Magicraps/Volt/README.md

# Volt
Vehicle Operations and Launch Telemetry - AerospaceNU's rocketry flight controller
https://github.com/AerospaceNU

Currently working on V1.
Open files in KiCAD. (I'm currently using V9.0)
