Magicraps/Volt/VoltV1/VoltV1.kicad_pcb

## KiCad design VoltV1/VoltV1.kicad_pcb (2026-06-28)

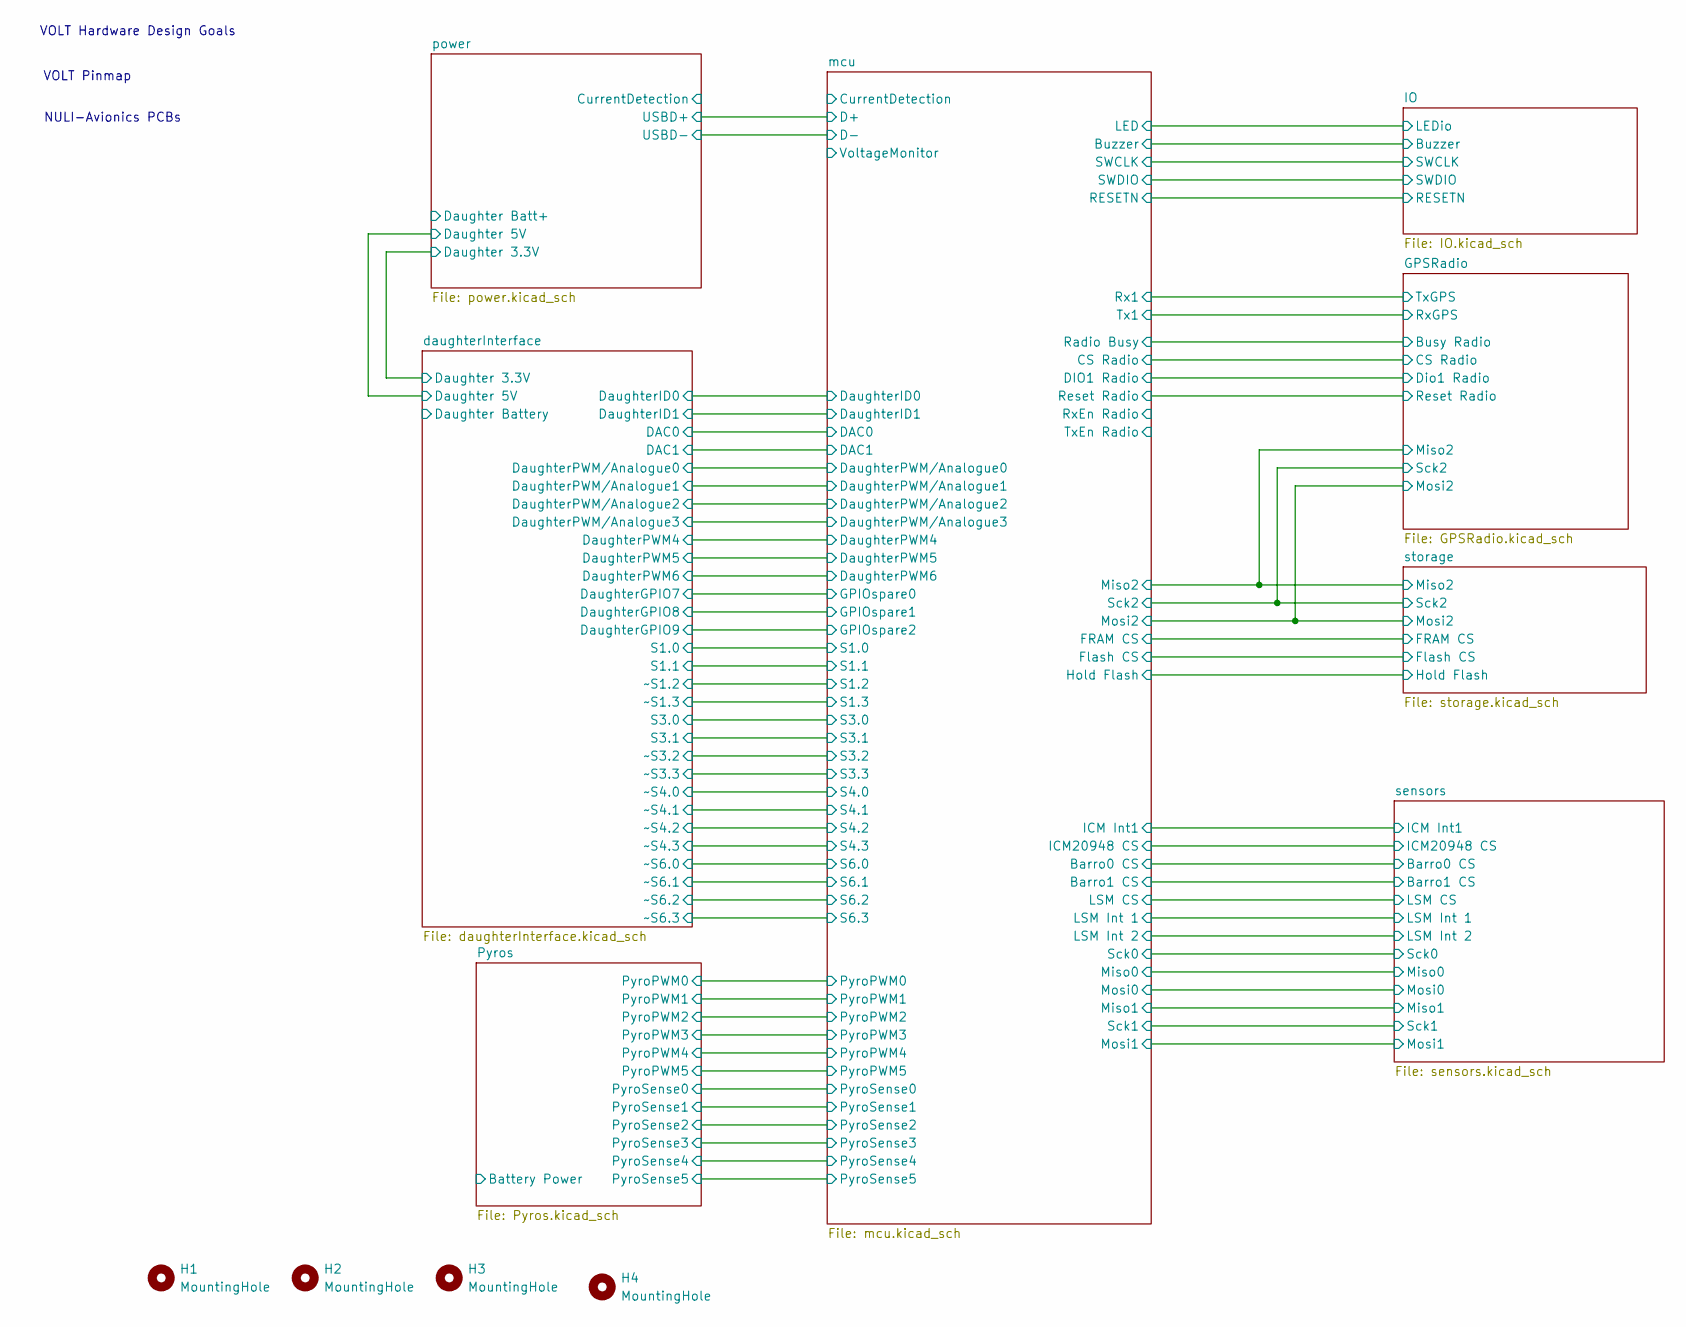
[picture p1: schematic VoltV1.kicad_sch, Volt]

Parts:
H1, H2, H3, H4: MountingHole; FixedMountingHole_2.5mm_Pad

Notes on the sheet:
NULI-Avionics PCBs
VOLT Hardware Design Goals
VOLT Pinmap

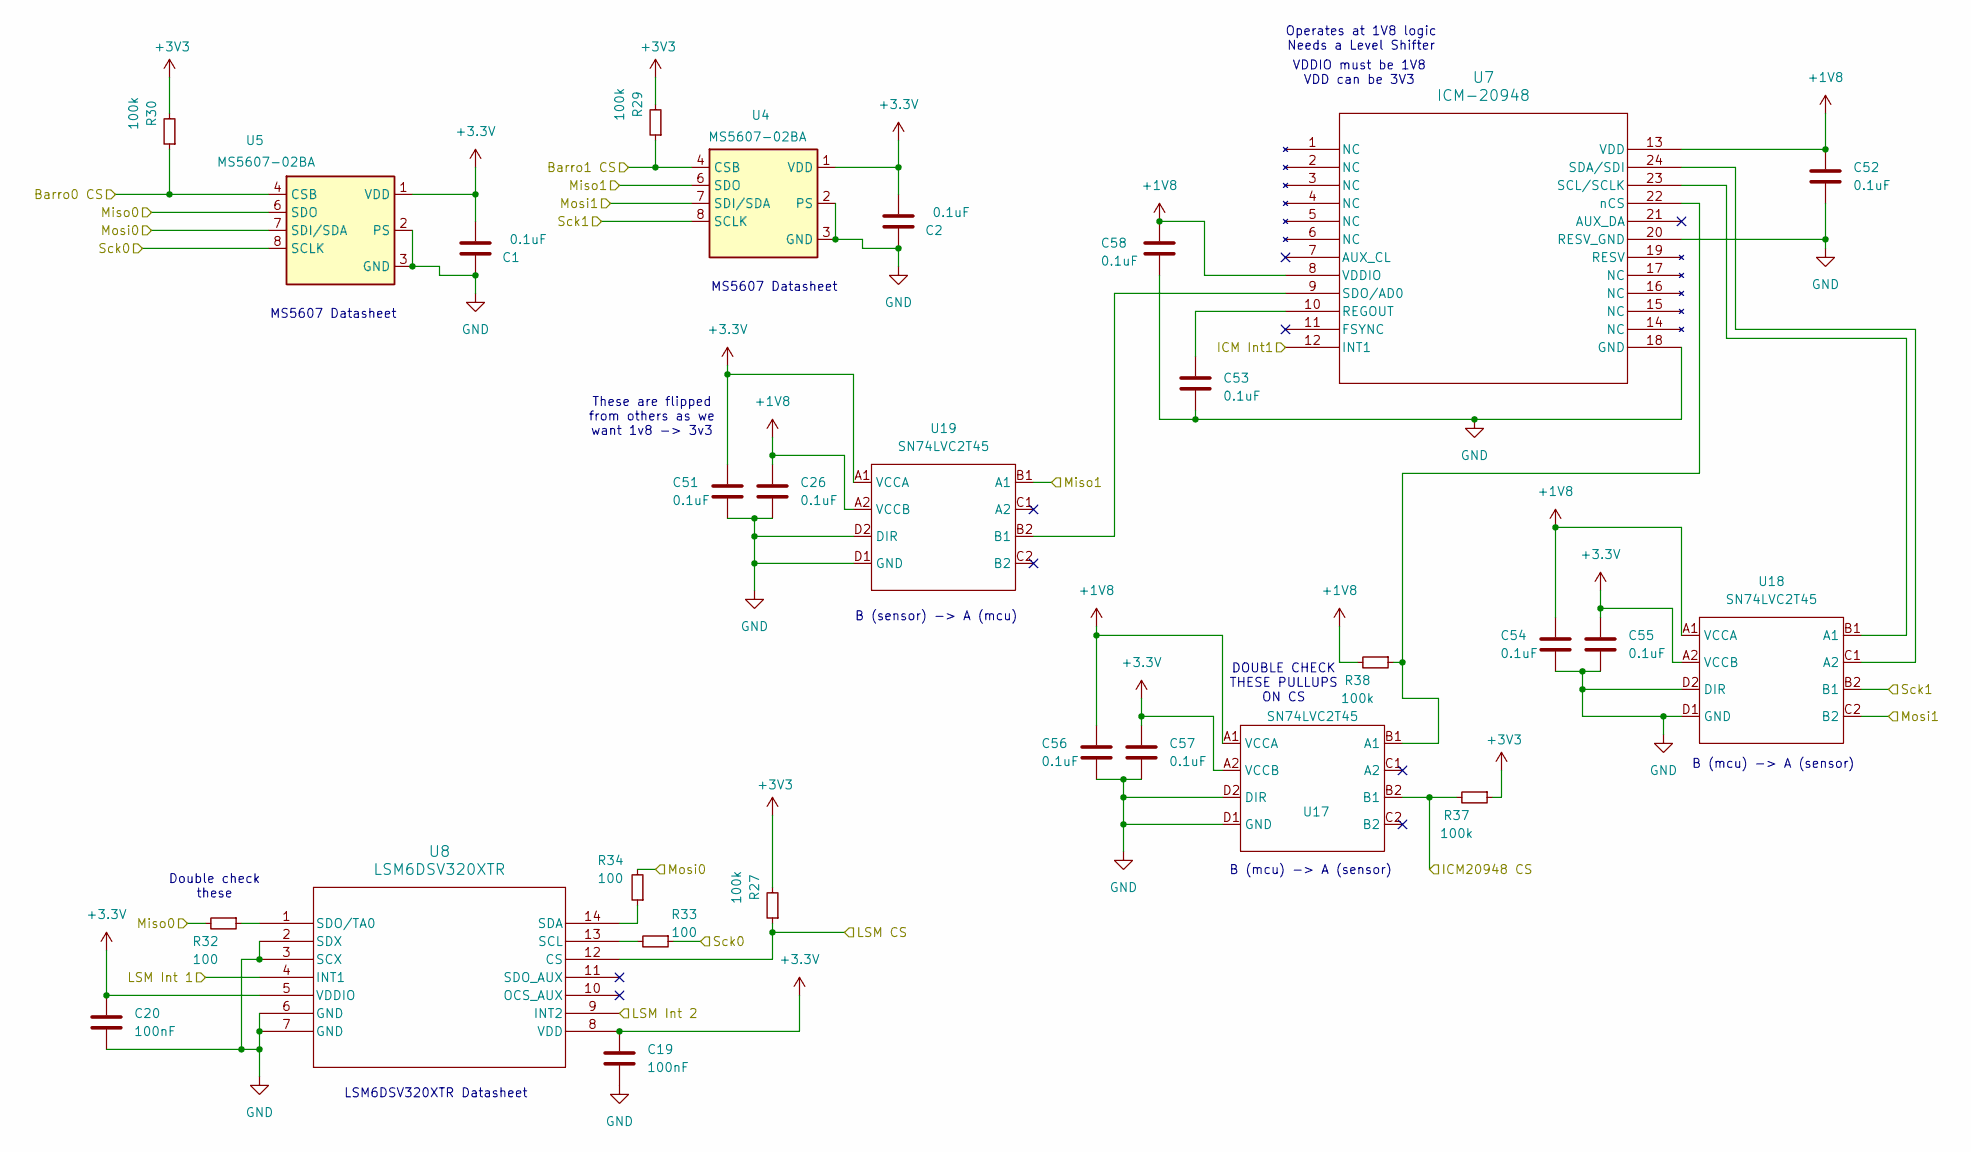
[picture p2: schematic sensors.kicad_sch]

Parts:
C1, C2, C26, C51, C52, C53, C54, C55, C56, C57, C58: 0.1uF; C_0402_1005Metric
C19, C20: 100nF; C_0402_1005Metric
R27, R29, R30, R37, R38: 100k; R_0402_1005Metric; LCSC C25077
R32, R33, R34: 100; R_0402_1005Metric; LCSC C25077
U4, U5: MS5607-02BA; LGA-8_3x5mm_P1.25mm
U7: ICM-20948; ICM_20948
U8: LSM6DSV320XTR
U17, U18, U19: SN74LVC2T45; Texas_DSBGA-8_0.9x1.9mm_Layout2x4_P0.5mm

Connections:
+1V8: C26.1, C52.1, C54.1, C56.1, C58.2, R38.2, U7.8 (VDDIO), U7.13 (VDD), U17.A1 (VCCA), U18.A1 (VCCA), U19.A2 (VCCB)
+3.3V: C1.2, C2.2, C19.1, C20.2, C51.1, C55.1, C57.1, U4.1 (VDD), U5.1 (VDD), U8.5 (VDDIO), U8.8 (VDD), U17.A2 (VCCB), U18.A2 (VCCB), U19.A1 (VCCA); also elsewhere on the board
+3V3: R27.2, R29.2, R30.2, R37.1; also elsewhere on the board
/mcu/Barro0 CS: R30.1, U5.4 (CSB); also elsewhere on the board
/mcu/Barro1 CS: R29.1, U4.4 (CSB); also elsewhere on the board
/mcu/ICM20948 CS: R37.2, U17.B2 (B1); also elsewhere on the board
/mcu/ICM Int1: U7.12 (INT1); also elsewhere on the board
/mcu/LSM CS: R27.1, U8.12 (CS); also elsewhere on the board
/mcu/LSM Int 1: U8.4 (INT1); also elsewhere on the board
/mcu/LSM Int 2: U8.9 (INT2); also elsewhere on the board
/mcu/Miso0: R32.2, U5.6 (SDO); also elsewhere on the board
/mcu/Miso1: U4.6 (SDO), U19.B1 (A1); also elsewhere on the board
/mcu/Mosi0: R34.2, U5.7 (SDI/SDA); also elsewhere on the board
/mcu/Mosi1: U4.7 (SDI/SDA), U18.C2 (B2); also elsewhere on the board
/mcu/Sck0: R33.1, U5.8 (SCLK); also elsewhere on the board
/mcu/Sck1: U4.8 (SCLK), U18.B2 (B1); also elsewhere on the board
GND: C1.1, C2.1, C19.2, C20.1, C26.2, C51.2, C52.2, C53.1, C54.2, C55.2, C56.2, C57.2, C58.1, U4.2 (PS), U4.3 (GND), U5.2 (PS), U5.3 (GND), U7.18 (GND), U7.20 (RESV_GND), U8.2 (SDX), U8.3 (SCX), U8.6 (GND), U8.7 (GND), U17.D1 (GND), U17.D2 (DIR), U18.D1 (GND), U18.D2 (DIR), U19.D1 (GND), U19.D2 (DIR); also elsewhere on the board
unnamed: C53.2, U7.10 (REGOUT)
unnamed: R33.2, U8.13 (SCL)
unnamed: R34.1, U8.14 (SDA)
unnamed: R32.1, U8.1 (SDO/TA0)
unnamed: R38.1, U7.22 (nCS), U17.B1 (A1)
unnamed: U7.23 (SCL/SCLK), U18.B1 (A1)
unnamed: U7.24 (SDA/SDI), U18.C1 (A2)
unnamed: U7.9 (SDO/AD0), U19.B2 (B1)

Notes on the sheet:
B (mcu) -> A (sensor)
LSM6DSV320XTR Datasheet
MS5607 Datasheet
VDDIO must be 1V8 VDD can be 3V3
Double check these
DOUBLE CHECK THESE PULLUPS ON CS
B (sensor) -> A (mcu)
These are flipped from others as we want 1v8 -> 3v3
Operates at 1V8 logic Needs a Level Shifter

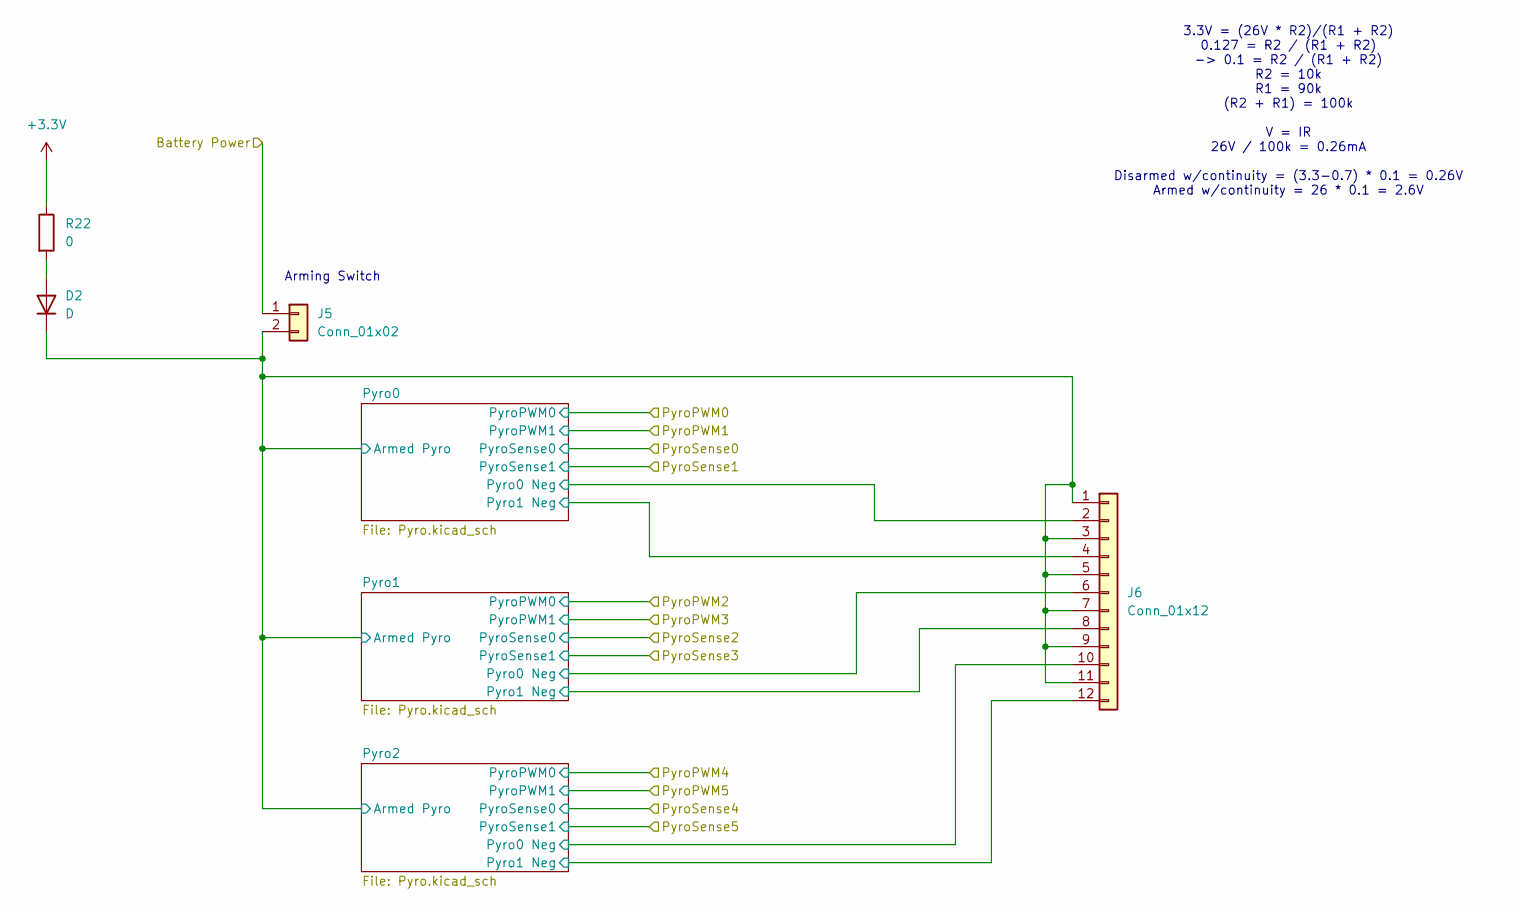
[picture p3: schematic Pyros.kicad_sch]

Parts:
D2: D
J5: Conn_01x02
J6: Conn_01x12
R22: 0; R_0402_1005Metric

Connections:
+3.3V: R22.1; also elsewhere on the board
unnamed: D2.2 (A), R22.2
unnamed: D2.1 (K), J5.2, J6.1, J6.3, J6.5, J6.7, J6.9, J6.11

Notes on the sheet:
Arming Switch
3.3V = (26V * R2)/(R1 + R2) 0.127 = R2 / (R1 + R2) -> 0.1 = R2 / (R1 + R2) R2 = 10k R1 = 90k (R2 + R1) = 100k V = IR 26V / 100k = 0.26mA Disarmed w/continuity = (3.3-0.7) * 0.1 = 0.26V Armed w/continuity = 26 * 0.1 = 2.6V

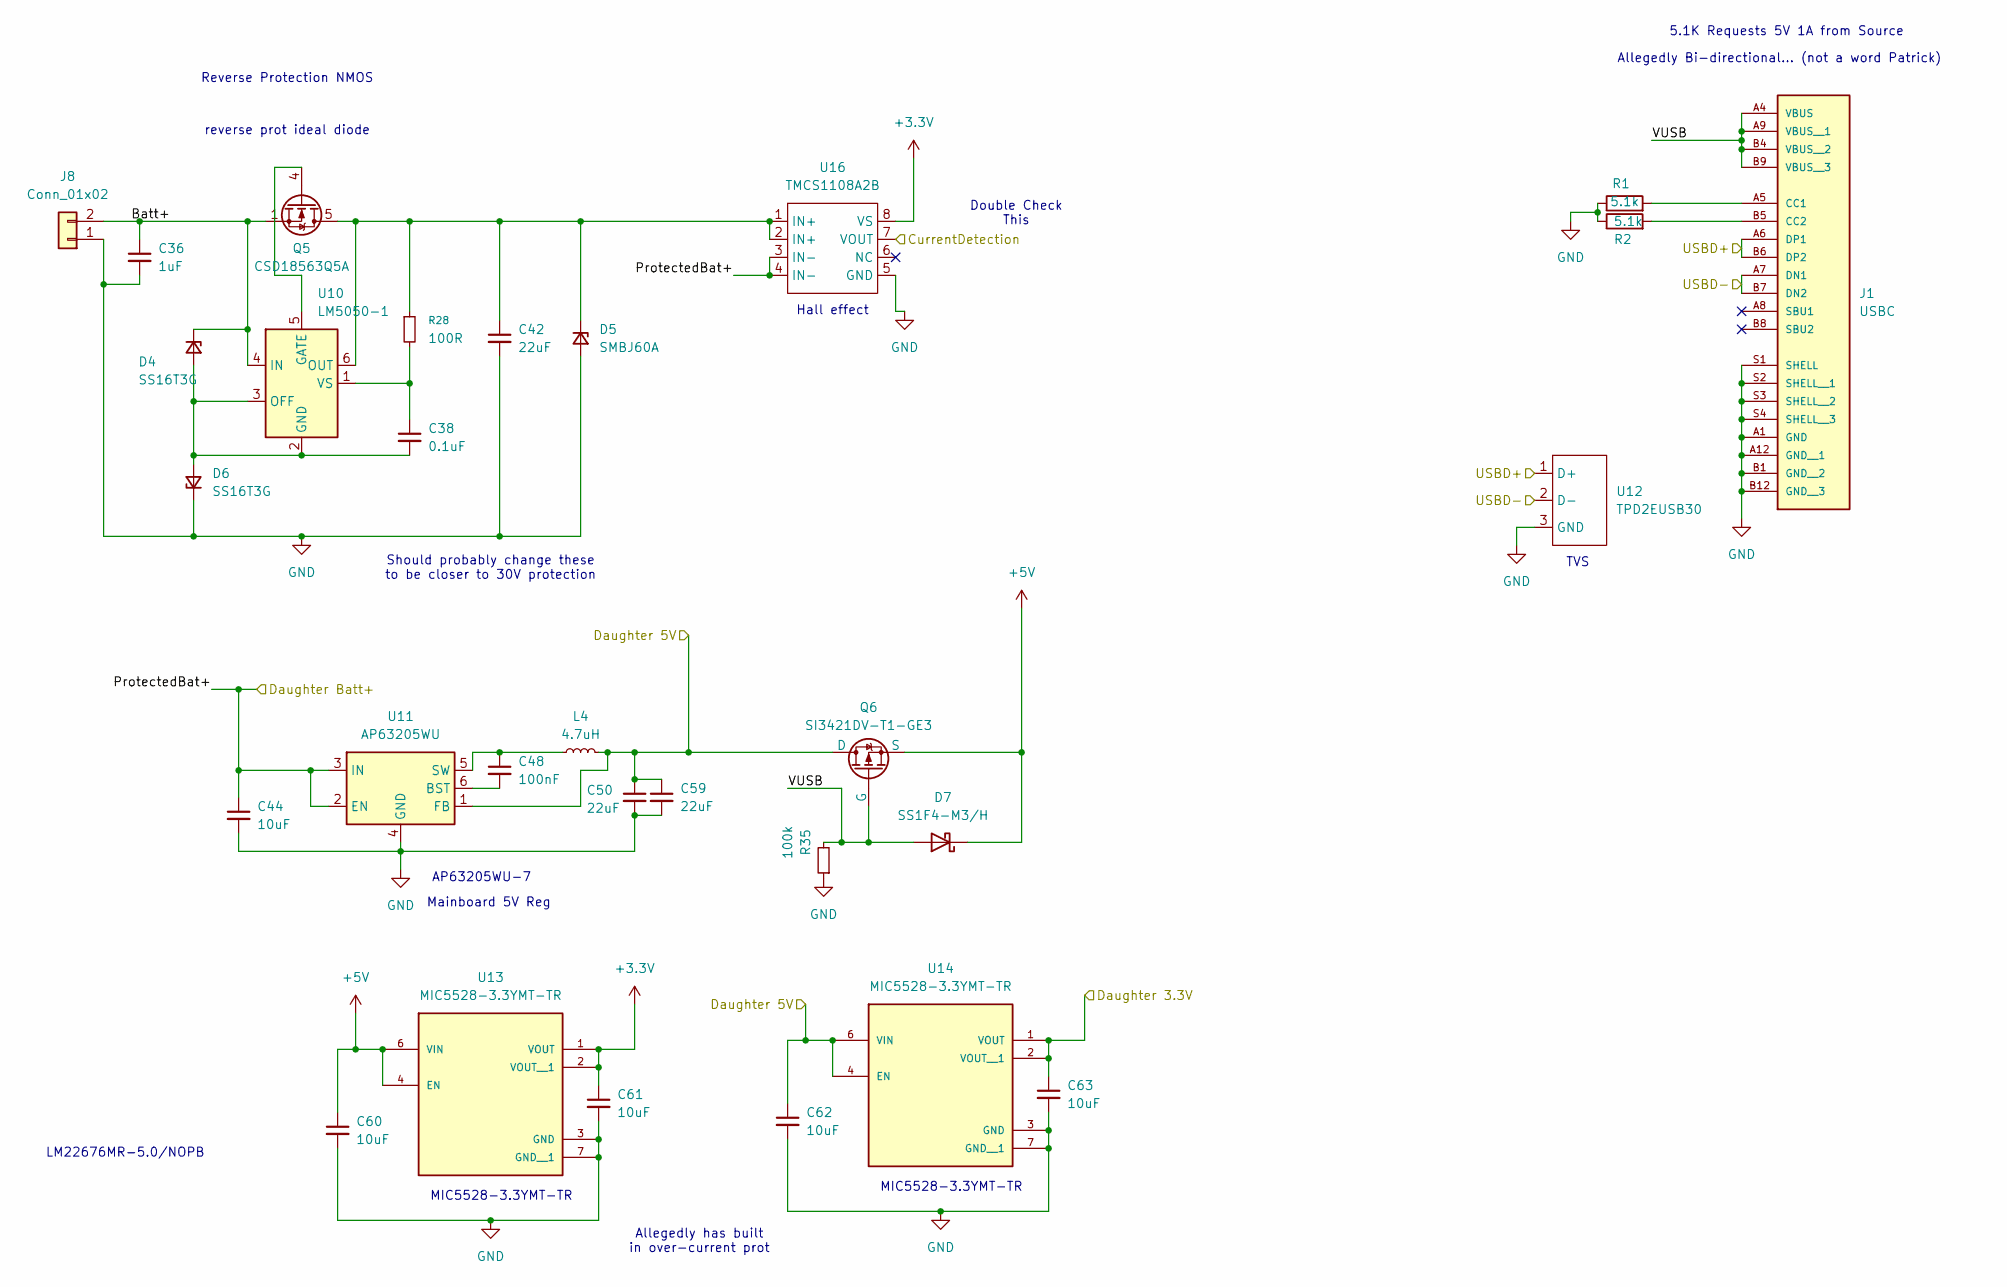
[picture p4: schematic power.kicad_sch]

Parts:
C36: 1uF; C_0402_1005Metric
C38: 0.1uF; C_0402_1005Metric
C42, C50, C59: 22uF; C_0402_1005Metric
C44, C60, C61, C62, C63: 10uF; C_0402_1005Metric
C48: 100nF; C_0402_1005Metric
D4, D6: SS16T3G
D5: SMBJ60A
D7: SS1F4-M3/H; D_SOD-123
J1: USBC; PARTREV B
J8: Conn_01x02
L4: 4.7uH; L_0603_1608Metric
Q5: CSD18563Q5A; TDSON-8-1
Q6: SI3421DV-T1-GE3; TSOP-6_1.65x3.05mm_P0.95mm
R1, R2: 5.1k; R_0402_1005Metric
R28: 100R; R_0402_1005Metric
R35: 100k; R_0402_1005Metric; LCSC C25077
U10: LM5050-1; TSOT-23-6
U11: AP63205WU; TSOT-23-6
U12: TPD2EUSB30; Texas_DRT-3
U13, U14: MIC5528-3.3YMT-TR; SON40P120X120X60-7N
U16: TMCS1108A2B; SOIC-8_3.9x4.9mm_P1.27mm

Connections:
+3.3V: C61.1, U13.1 (VOUT), U13.2 (VOUT__1), U16.8 (VS); also elsewhere on the board
+5V: C60.1, D7.1 (K), Q6.4 (S), U13.4 (EN), U13.6 (VIN)
/daughterInterface/Daughter 3.3V: C63.1, U14.1 (VOUT), U14.2 (VOUT__1); also elsewhere on the board
/daughterInterface/Daughter 5V: C50.1, C59.1, C62.1, L4.2, Q6.1 (D), Q6.2 (D), Q6.5 (D), Q6.6 (D), U11.1 (FB), U14.4 (EN), U14.6 (VIN); also elsewhere on the board
/mcu/D+: J1.A6 (DP1), J1.B6 (DP2), U12.1 (D+); also elsewhere on the board
/mcu/D-: J1.A7 (DN1), J1.B7 (DN2), U12.2 (D-); also elsewhere on the board
/power/CurrentDetection: U16.7 (VOUT)
/power/ProtectedBat+: C44.1, U11.2 (EN), U11.3 (IN), U16.3 (IN-), U16.4 (IN-)
/power/VUSB: D7.2 (A), J1.A4 (VBUS), J1.A9 (VBUS__1), J1.B4 (VBUS__2), J1.B9 (VBUS__3), Q6.3 (G), R35.2
GND: C36.2, C42.2, C44.2, C50.2, C59.2, C60.2, C61.2, C62.2, C63.2, D5.2 (A), D6.1 (K), J1.A1 (GND), J1.A12 (GND__1), J1.B1 (GND__2), J1.B12 (GND__3), J1.S1 (SHELL), J1.S2 (SHELL__1), J1.S3 (SHELL__2), J1.S4 (SHELL__3), J8.1, R1.1, R2.1, R35.1, U11.4 (GND), U12.3 (GND), U13.3 (GND), U13.7 (GND__1), U14.3 (GND), U14.7 (GND__1), U16.5 (GND); also elsewhere on the board
unnamed: C38.2, D4.2 (A), D6.2 (A), U10.2 (GND), U10.3 (OFF)
unnamed: J1.A5 (CC1), R1.2
unnamed: J1.B5 (CC2), R2.2
unnamed: Q5.4 (G), U10.5 (GATE)
unnamed: C38.1, R28.2, U10.1 (VS)
unnamed: C48.2, U11.6 (BST)
unnamed: C48.1, L4.1, U11.5 (SW)

Notes on the sheet:
LM22676MR-5.0/NOPB
Double Check This
Should probably change these to be closer to 30V protection
Reverse Protection NMOS
TVS
Allegedly has built in over-current prot
Hall effect
MIC5528-3.3YMT-TR
Allegedly Bi-directional... (not a word Patrick)
Mainboard 5V Reg
reverse prot ideal diode
5.1K Requests 5V 1A from Source
AP63205WU-7

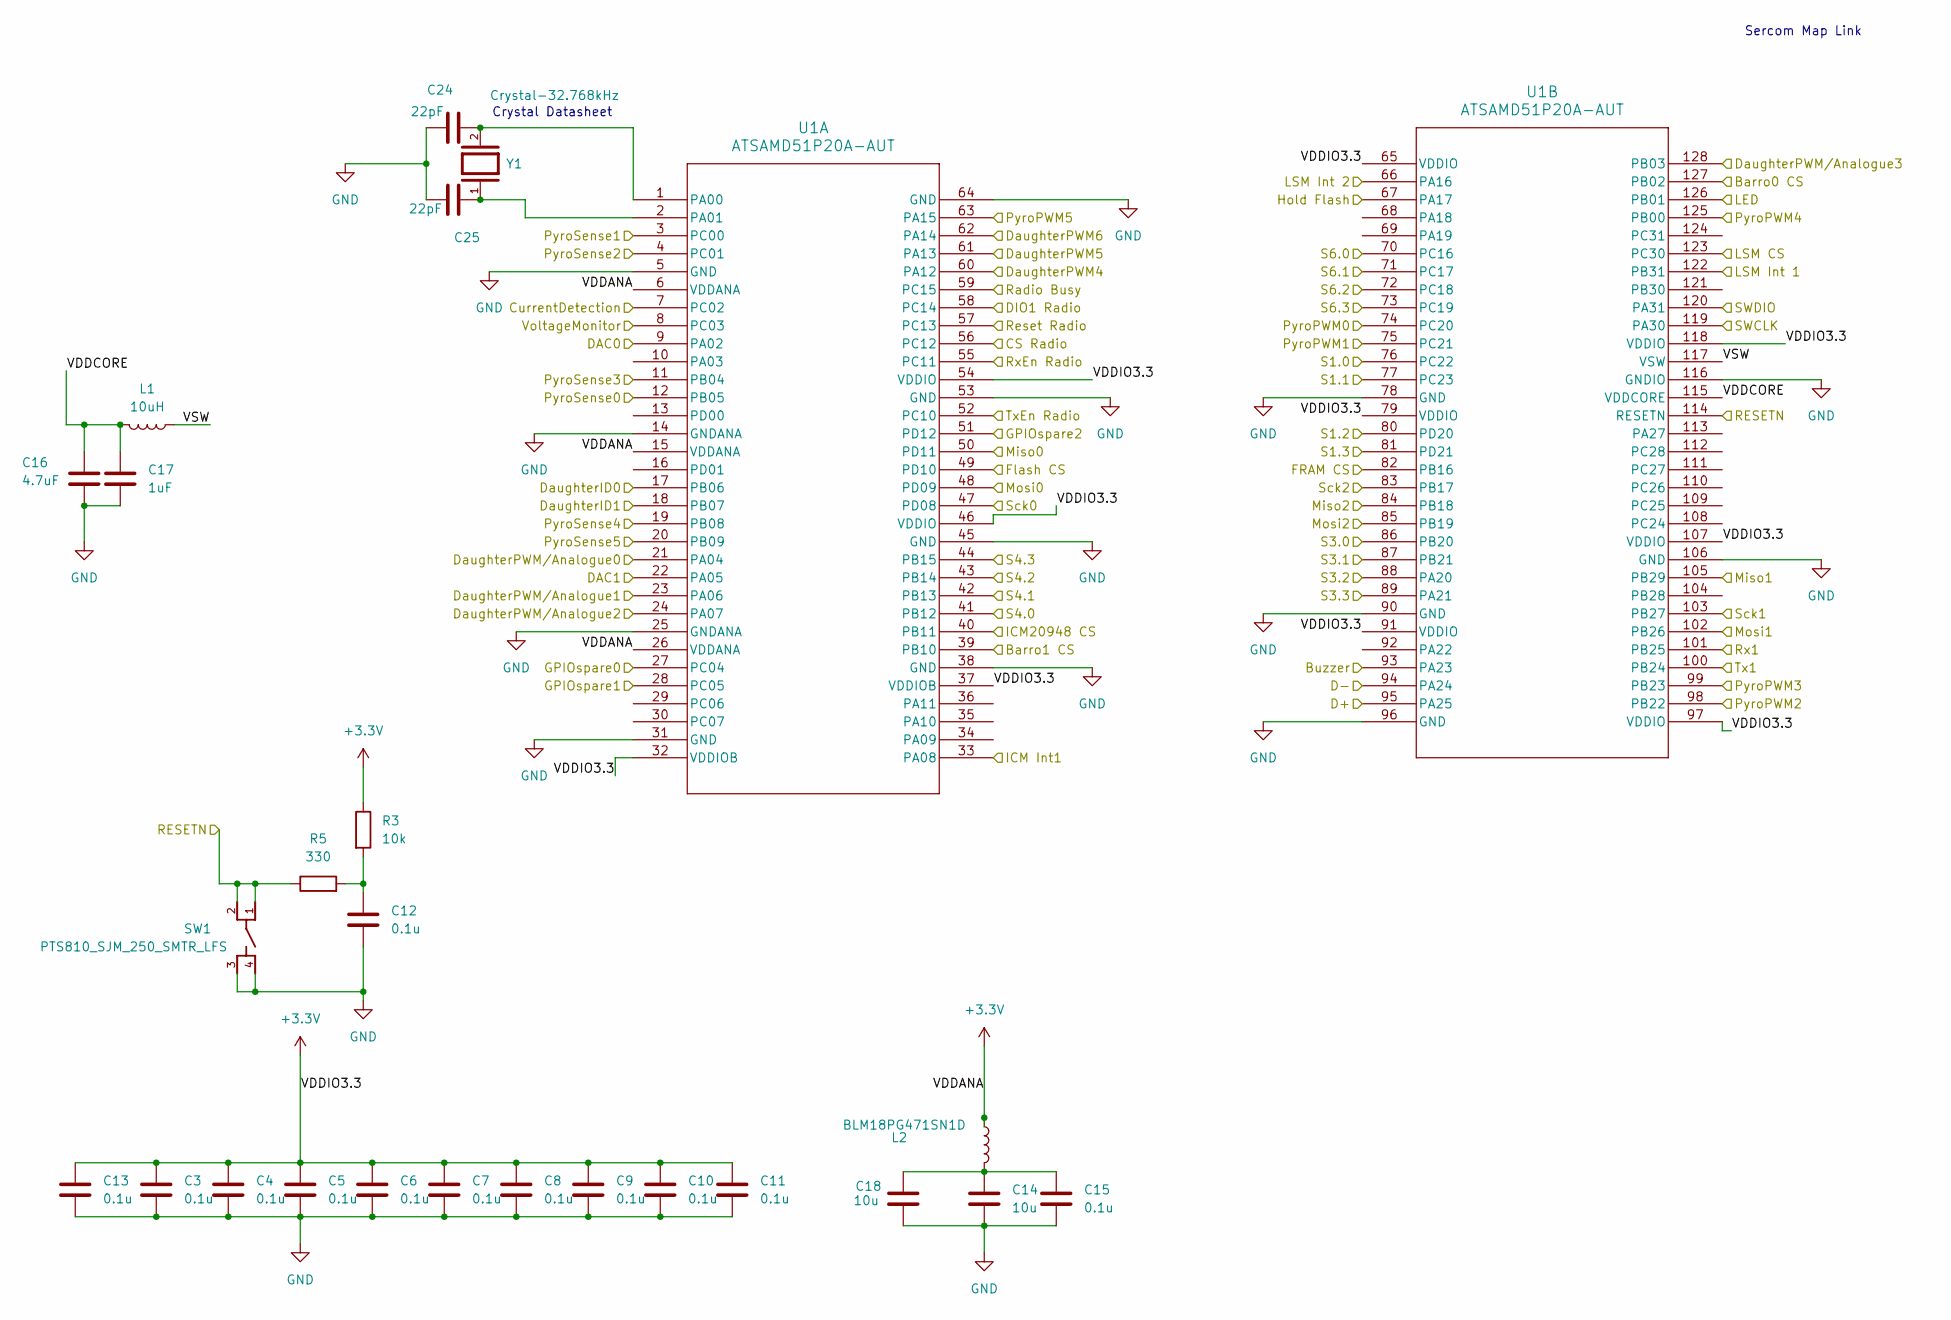
[picture p5: schematic mcu.kicad_sch]

Parts:
C3, C4, C5, C6, C7, C8, C9, C10, C11, C12, C13, C15: 0.1u; C_0402_1005Metric
C14, C18: 10u; C_0402_1005Metric
C16: 4.7uF; C_0402_1005Metric
C17: 1uF; C_0402_1005Metric
C24, C25: 22pF; C_0402_1005Metric
L1: 10uH; L_0603_1608Metric
L2: BLM18PG471SN1D; L_0603_1608Metric
R3: 10k; R_0402_1005Metric
R5: 330; R_0402_1005Metric
SW1: PTS810_SJM_250_SMTR_LFS; SW_PTS810_SJM_250_SMTR_LFS
U1: ATSAMD51P20A-AUT
Y1: Crystal-32.768kHz; XTAL_ABS07-32.768KHZ-T; PARTREV 08.19.15

Connections:
+3.3V: C3.1, C4.1, C5.1, C6.1, C7.1, C8.1, C9.1, C10.1, C11.1, C13.1, L2.1, R3.1, U1.6 (VDDANA), U1.15 (VDDANA), U1.26 (VDDANA), U1.32 (VDDIOB), U1.37 (VDDIOB), U1.46 (VDDIO), U1.54 (VDDIO), U1.65 (VDDIO), U1.79 (VDDIO), U1.91 (VDDIO), U1.97 (VDDIO), U1.107 (VDDIO), U1.118 (VDDIO); also elsewhere on the board
/GPSRadio/Busy Radio: U1.59 (PC15); also elsewhere on the board
/GPSRadio/CS Radio: U1.56 (PC12); also elsewhere on the board
/GPSRadio/Dio1 Radio: U1.58 (PC14); also elsewhere on the board
/GPSRadio/Miso2: U1.84 (PB18); also elsewhere on the board
/GPSRadio/Mosi2: U1.85 (PB19); also elsewhere on the board
/GPSRadio/Reset Radio: U1.57 (PC13); also elsewhere on the board
/GPSRadio/RxGPS: U1.100 (PB24); also elsewhere on the board
/GPSRadio/Sck2: U1.83 (PB17); also elsewhere on the board
/GPSRadio/TxGPS: U1.101 (PB25); also elsewhere on the board
/IO/Buzzer: U1.93 (PA23); also elsewhere on the board
/IO/LEDio: U1.126 (PB01); also elsewhere on the board
/IO/RESETN: R5.1, SW1.1, SW1.2, U1.114 (RESETN); also elsewhere on the board
/IO/SWCLK: U1.119 (PA30); also elsewhere on the board
/IO/SWDIO: U1.120 (PA31); also elsewhere on the board
/Pyros/PyroPWM0: U1.74 (PC20); also elsewhere on the board
/Pyros/PyroPWM1: U1.75 (PC21); also elsewhere on the board
/Pyros/PyroPWM2: U1.98 (PB22); also elsewhere on the board
/Pyros/PyroPWM3: U1.99 (PB23); also elsewhere on the board
/Pyros/PyroPWM4: U1.125 (PB00); also elsewhere on the board
/Pyros/PyroPWM5: U1.63 (PA15); also elsewhere on the board
/Pyros/PyroSense0: U1.12 (PB05); also elsewhere on the board
/Pyros/PyroSense1: U1.3 (PC00); also elsewhere on the board
/Pyros/PyroSense2: U1.4 (PC01); also elsewhere on the board
/Pyros/PyroSense3: U1.11 (PB04); also elsewhere on the board
/Pyros/PyroSense4: U1.19 (PB08); also elsewhere on the board
/Pyros/PyroSense5: U1.20 (PB09); also elsewhere on the board
/daughterInterface/DAC0: U1.9 (PA02); also elsewhere on the board
/daughterInterface/DAC1: U1.22 (PA05); also elsewhere on the board
/daughterInterface/DaughterGPIO7: U1.27 (PC04); also elsewhere on the board
/daughterInterface/DaughterGPIO8: U1.28 (PC05); also elsewhere on the board
/daughterInterface/DaughterGPIO9: U1.51 (PD12); also elsewhere on the board
/daughterInterface/DaughterID0: U1.17 (PB06); also elsewhere on the board
/daughterInterface/DaughterID1: U1.18 (PB07); also elsewhere on the board
/daughterInterface/DaughterPWM4: U1.60 (PA12); also elsewhere on the board
/daughterInterface/DaughterPWM5: U1.61 (PA13); also elsewhere on the board
/daughterInterface/DaughterPWM6: U1.62 (PA14); also elsewhere on the board
/daughterInterface/DaughterPWM/Analogue0: U1.21 (PA04); also elsewhere on the board
/daughterInterface/DaughterPWM/Analogue1: U1.23 (PA06); also elsewhere on the board
/daughterInterface/DaughterPWM/Analogue2: U1.24 (PA07); also elsewhere on the board
/daughterInterface/DaughterPWM/Analogue3: U1.128 (PB03); also elsewhere on the board
/daughterInterface/S1.0: U1.76 (PC22); also elsewhere on the board
/daughterInterface/S1.1: U1.77 (PC23); also elsewhere on the board
/daughterInterface/S3.0: U1.86 (PB20); also elsewhere on the board
/daughterInterface/S3.1: U1.87 (PB21); also elsewhere on the board
/daughterInterface/~S1.2: U1.80 (PD20); also elsewhere on the board
/daughterInterface/~S1.3: U1.81 (PD21); also elsewhere on the board
/daughterInterface/~S3.2: U1.88 (PA20); also elsewhere on the board
/daughterInterface/~S3.3: U1.89 (PA21); also elsewhere on the board
/daughterInterface/~S4.0: U1.41 (PB12); also elsewhere on the board
/daughterInterface/~S4.1: U1.42 (PB13); also elsewhere on the board
/daughterInterface/~S4.2: U1.43 (PB14); also elsewhere on the board
/daughterInterface/~S4.3: U1.44 (PB15); also elsewhere on the board
/daughterInterface/~S6.0: U1.70 (PC16); also elsewhere on the board
/daughterInterface/~S6.1: U1.71 (PC17); also elsewhere on the board
/daughterInterface/~S6.2: U1.72 (PC18); also elsewhere on the board
/daughterInterface/~S6.3: U1.73 (PC19); also elsewhere on the board
/mcu/Barro0 CS: U1.127 (PB02); also elsewhere on the board
/mcu/Barro1 CS: U1.39 (PB10); also elsewhere on the board
/mcu/CurrentDetection: U1.7 (PC02)
/mcu/D+: U1.95 (PA25); also elsewhere on the board
/mcu/D-: U1.94 (PA24); also elsewhere on the board
/mcu/FRAM CS: U1.82 (PB16); also elsewhere on the board
/mcu/Flash CS: U1.49 (PD10); also elsewhere on the board
/mcu/Hold Flash: U1.67 (PA17); also elsewhere on the board
/mcu/ICM20948 CS: U1.40 (PB11); also elsewhere on the board
/mcu/ICM Int1: U1.33 (PA08); also elsewhere on the board
/mcu/LSM CS: U1.123 (PC30); also elsewhere on the board
/mcu/LSM Int 1: U1.122 (PB31); also elsewhere on the board
/mcu/LSM Int 2: U1.66 (PA16); also elsewhere on the board
/mcu/Miso0: U1.50 (PD11); also elsewhere on the board
/mcu/Miso1: U1.105 (PB29); also elsewhere on the board
/mcu/Mosi0: U1.48 (PD09); also elsewhere on the board
/mcu/Mosi1: U1.102 (PB26); also elsewhere on the board
/mcu/RxEn Radio: U1.55 (PC11)
/mcu/Sck0: U1.47 (PD08); also elsewhere on the board
/mcu/Sck1: U1.103 (PB27); also elsewhere on the board
/mcu/TxEn Radio: U1.52 (PC10)
/mcu/VDDCORE: C16.1, C17.1, L1.2, U1.115 (VDDCORE)
/mcu/VSW: L1.1, U1.117 (VSW)
/mcu/VoltageMonitor: U1.8 (PC03)
GND: C3.2, C4.2, C5.2, C6.2, C7.2, C8.2, C9.2, C10.2, C11.2, C12.2, C13.2, C14.2, C15.2, C16.2, C17.2, C18.2, C24.2, C25.2, SW1.3, SW1.4, U1.5 (GND), U1.14 (GNDANA), U1.25 (GNDANA), U1.31 (GND), U1.38 (GND), U1.45 (GND), U1.53 (GND), U1.64 (GND), U1.78 (GND), U1.90 (GND), U1.96 (GND), U1.106 (GND), U1.116 (GNDIO); also elsewhere on the board
unnamed: C12.1, R3.2, R5.2
unnamed: C14.1, C15.1, C18.1, L2.2
unnamed: C24.1, U1.1 (PA00), Y1.2
unnamed: C25.1, U1.2 (PA01), Y1.1

Notes on the sheet:
Crystal Datasheet
Sercom Map Link

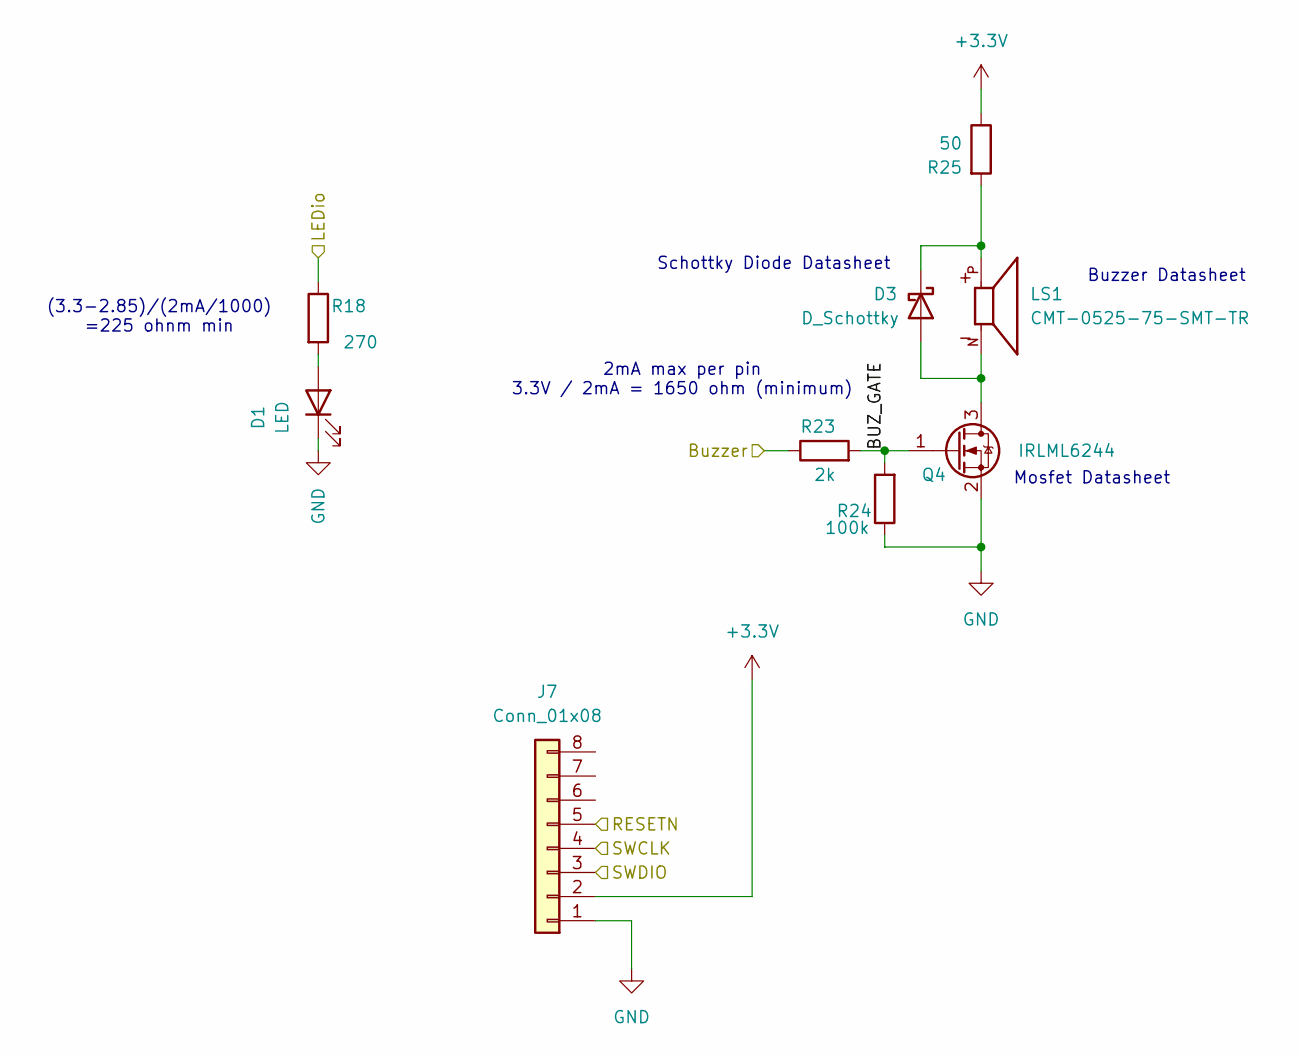
[picture p6: schematic IO.kicad_sch]

Parts:
D1: LED; LED_0603_1608Metric
D3: D_Schottky; D_SOD-123
J7: Conn_01x08; JST_GH_BM08B-GHS-TBT_1x08-1MP_P1.25mm_Vertical
LS1: CMT-0525-75-SMT-TR; XDCR_CMT-0525-75-SMT-TR; PARTREV 1.0
Q4: IRLML6244; SOT-23
R18: 270; R_0402_1005Metric
R23: 2k; R_0402_1005Metric
R24: 100k; R_0402_1005Metric
R25: 50; R_0402_1005Metric

Connections:
+3.3V: J7.2, R25.1; also elsewhere on the board
/IO/BUZ_GATE: Q4.1 (G), R23.2, R24.2
/IO/Buzzer: R23.1; also elsewhere on the board
/IO/LEDio: R18.1; also elsewhere on the board
/IO/RESETN: J7.5; also elsewhere on the board
/IO/SWCLK: J7.4; also elsewhere on the board
/IO/SWDIO: J7.3; also elsewhere on the board
GND: D1.1 (K), J7.1, Q4.2 (S), R24.1; also elsewhere on the board
unnamed: D1.2 (A), R18.2
unnamed: D3.2 (A), LS1.N, Q4.3 (D)
unnamed: D3.1 (K), LS1.P, R25.2

Notes on the sheet:
Buzzer Datasheet
Schottky Diode Datasheet
(3.3-2.85)/(2mA/1000) =225 ohnm min
Mosfet Datasheet
2mA max per pin 3.3V / 2mA = 1650 ohm (minimum)

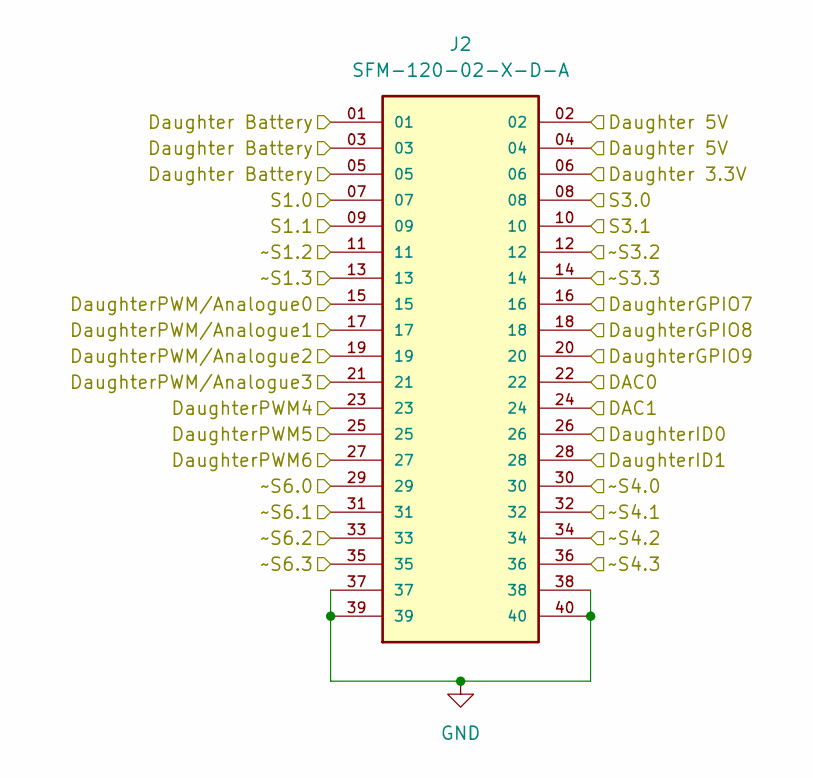
[picture p7: schematic daughterInterface.kicad_sch]

Parts:
J2: SFM-120-02-X-D-A; SAMTEC_SFM-120-02-X-D-A; PARTREV Q

Connections:
/daughterInterface/DAC0: J2.22; also elsewhere on the board
/daughterInterface/DAC1: J2.24; also elsewhere on the board
/daughterInterface/Daughter 3.3V: J2.06; also elsewhere on the board
/daughterInterface/Daughter 5V: J2.02, J2.04; also elsewhere on the board
/daughterInterface/Daughter Battery: J2.01, J2.03, J2.05
/daughterInterface/DaughterGPIO7: J2.16; also elsewhere on the board
/daughterInterface/DaughterGPIO8: J2.18; also elsewhere on the board
/daughterInterface/DaughterGPIO9: J2.20; also elsewhere on the board
/daughterInterface/DaughterID0: J2.26; also elsewhere on the board
/daughterInterface/DaughterID1: J2.28; also elsewhere on the board
/daughterInterface/DaughterPWM4: J2.23; also elsewhere on the board
/daughterInterface/DaughterPWM5: J2.25; also elsewhere on the board
/daughterInterface/DaughterPWM6: J2.27; also elsewhere on the board
/daughterInterface/DaughterPWM/Analogue0: J2.15; also elsewhere on the board
/daughterInterface/DaughterPWM/Analogue1: J2.17; also elsewhere on the board
/daughterInterface/DaughterPWM/Analogue2: J2.19; also elsewhere on the board
/daughterInterface/DaughterPWM/Analogue3: J2.21; also elsewhere on the board
/daughterInterface/S1.0: J2.07; also elsewhere on the board
/daughterInterface/S1.1: J2.09; also elsewhere on the board
/daughterInterface/S3.0: J2.08; also elsewhere on the board
/daughterInterface/S3.1: J2.10; also elsewhere on the board
/daughterInterface/~S1.2: J2.11; also elsewhere on the board
/daughterInterface/~S1.3: J2.13; also elsewhere on the board
/daughterInterface/~S3.2: J2.12; also elsewhere on the board
/daughterInterface/~S3.3: J2.14; also elsewhere on the board
/daughterInterface/~S4.0: J2.30; also elsewhere on the board
/daughterInterface/~S4.1: J2.32; also elsewhere on the board
/daughterInterface/~S4.2: J2.34; also elsewhere on the board
/daughterInterface/~S4.3: J2.36; also elsewhere on the board
/daughterInterface/~S6.0: J2.29; also elsewhere on the board
/daughterInterface/~S6.1: J2.31; also elsewhere on the board
/daughterInterface/~S6.2: J2.33; also elsewhere on the board
/daughterInterface/~S6.3: J2.35; also elsewhere on the board
GND: J2.37, J2.38, J2.39, J2.40; also elsewhere on the board
