Magicraps/Volt/VoltV1/VoltV1.kicad_pcb

## KiCad design VoltV1/VoltV1.kicad_pcb (continued)

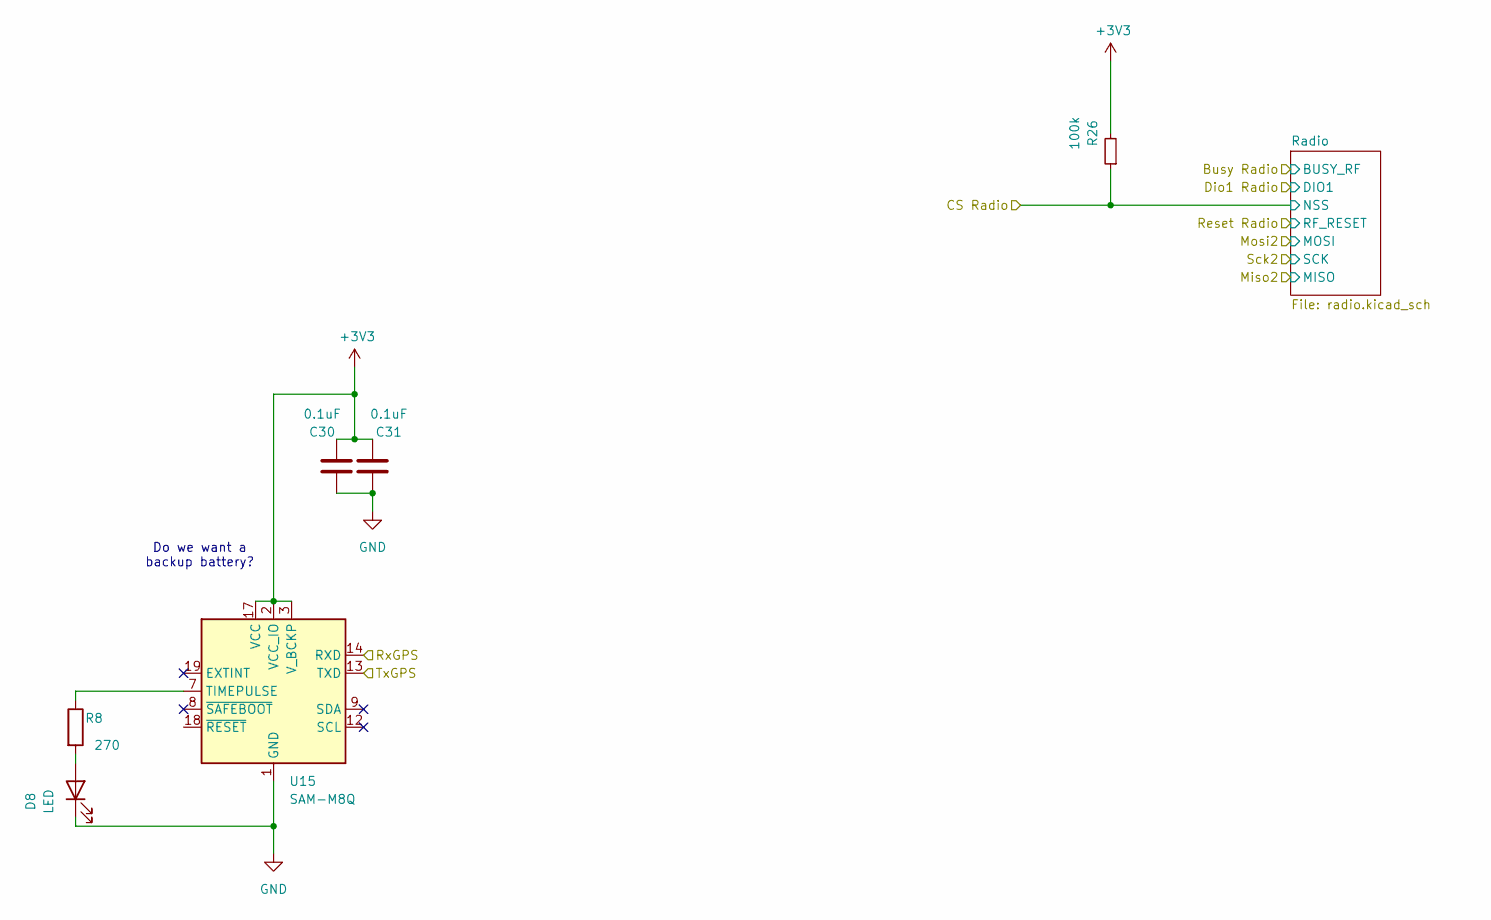
[picture p8: schematic GPSRadio.kicad_sch]

Parts:
C30, C31: 0.1uF; C_0402_1005Metric
D8: LED; LED_0603_1608Metric
R8: 270; R_0402_1005Metric
R26: 100k; R_0402_1005Metric; LCSC C25077
U15: SAM-M8Q; ublox_SAM-M8Q

Connections:
+3V3: C30.2, C31.2, R26.2, U15.2 (VCC_IO), U15.3 (V_BCKP), U15.17 (VCC); also elsewhere on the board
/GPSRadio/CS Radio: R26.1; also elsewhere on the board
/GPSRadio/RxGPS: U15.14 (RXD); also elsewhere on the board
/GPSRadio/TxGPS: U15.13 (TXD); also elsewhere on the board
GND: C30.1, C31.1, D8.1 (K), U15.1 (GND), U15.4 (GND), U15.5 (GND), U15.6 (GND), U15.10 (GND), U15.11 (GND), U15.15 (GND), U15.16 (GND), U15.20 (GND); also elsewhere on the board
unnamed: D8.2 (A), R8.2
unnamed: R8.1, U15.7 (TIMEPULSE)

Notes on the sheet:
Do we want a backup battery?

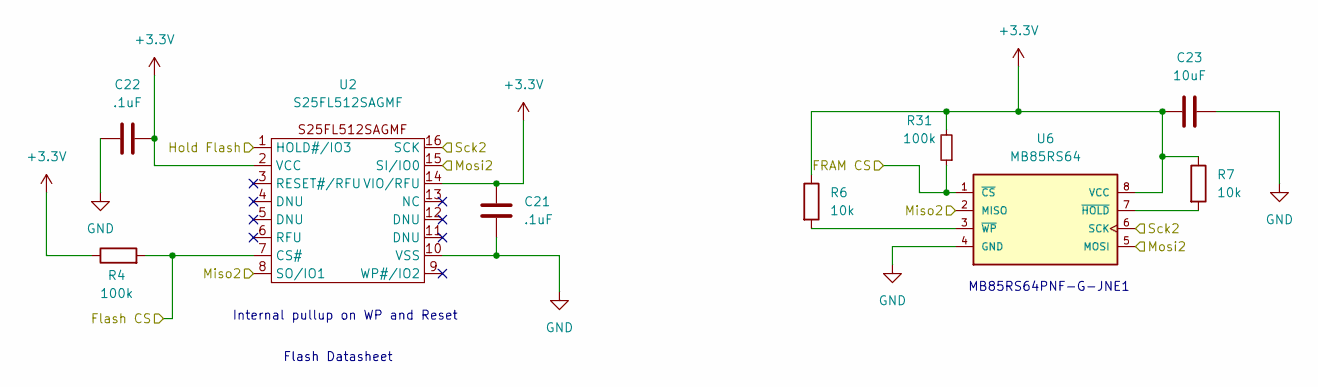
[picture p9: schematic storage.kicad_sch]

Parts:
C21, C22: .1uF; C_0402_1005Metric
C23: 10uF; C_0402_1005Metric
R4: 100k; R_0402_1005Metric
R6, R7: 10k; R_0402_1005Metric
R31: 100k; R_0402_1005Metric; LCSC C25077
U2: S25FL512SAGMF
U6: MB85RS64; SOIC127P600X155-8_R159_68_374R15

Connections:
+3.3V: C21.1, C22.2, C23.1, R4.1, R6.1, R7.1, R31.2, U2.2 (VCC), U2.14 (VIO/RFU), U6.8 (VCC); also elsewhere on the board
/GPSRadio/Miso2: U2.8 (SO/IO1), U6.2 (MISO); also elsewhere on the board
/GPSRadio/Mosi2: U2.15 (SI/IO0), U6.5 (MOSI); also elsewhere on the board
/GPSRadio/Sck2: U2.16 (SCK), U6.6 (SCK); also elsewhere on the board
/mcu/FRAM CS: R31.1, U6.1 (~CS); also elsewhere on the board
/mcu/Flash CS: R4.2, U2.7 (CS#); also elsewhere on the board
/mcu/Hold Flash: U2.1 (HOLD#/IO3); also elsewhere on the board
GND: C21.2, C22.1, C23.2, U2.10 (VSS), U6.4 (GND); also elsewhere on the board
unnamed: R7.2, U6.7 (~HOLD)
unnamed: R6.2, U6.3 (~WP)

Notes on the sheet:
Internal pullup on WP and Reset
Flash Datasheet
MB85RS64PNF-G-JNE1

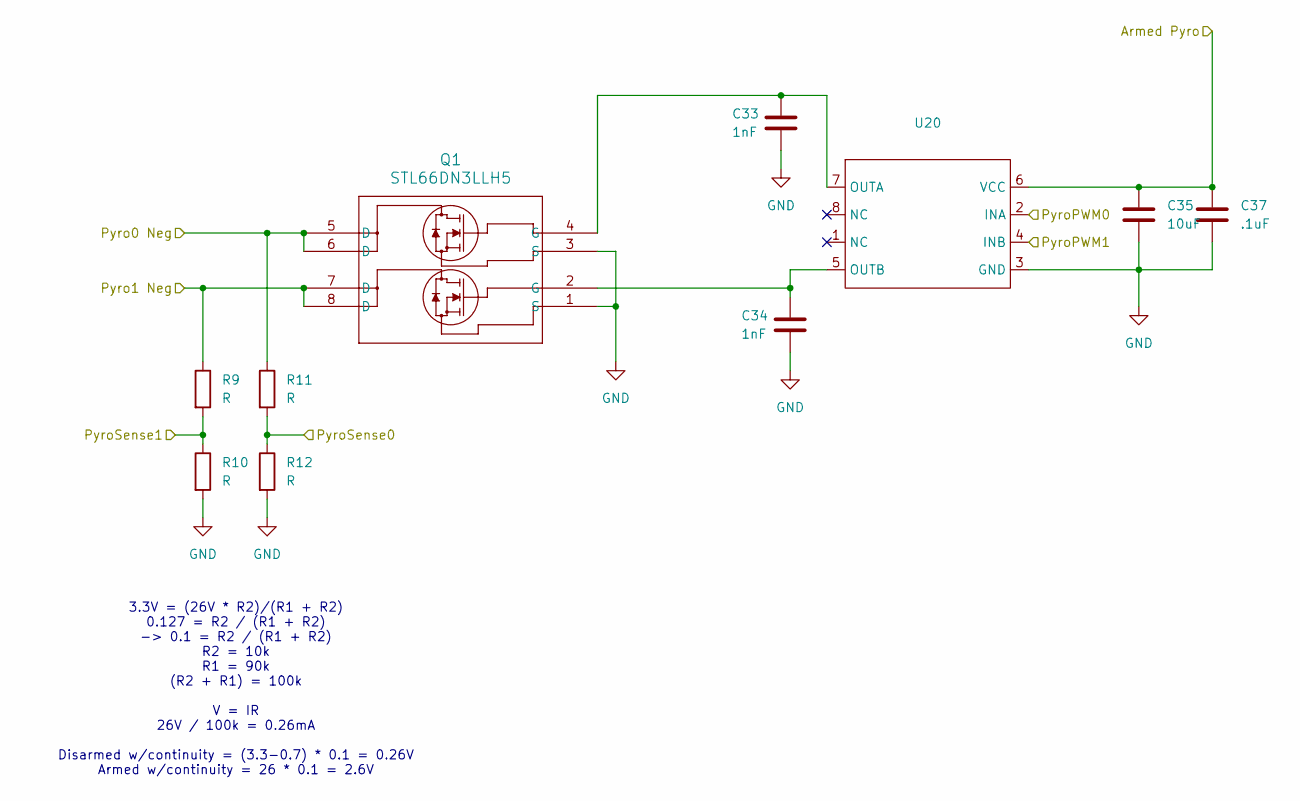
[picture p10: schematic Pyro.kicad_sch]

Parts:
C33, C34: 1nF; C_0402_1005Metric
C35: 10uF; C_0402_1005Metric
C37: .1uF; C_0402_1005Metric
Q1: STL66DN3LLH5; POWERFLAT5X6_STL66_STM
R9, R10, R11, R12: R; R_0402_1005Metric
U20: SOIC-8_3.9x4.9mm_P1.27mm

Connections:
/Pyros/Pyro0/Armed Pyro: C35.1, C37.1, U20.6 (VCC); also elsewhere on the board
/Pyros/Pyro0/Pyro0 Neg: Q1.5 (D), Q1.6 (D), R11.1
/Pyros/Pyro0/Pyro1 Neg: Q1.7 (D), Q1.8 (D), R9.1
/Pyros/PyroPWM0: U20.2 (INA); also elsewhere on the board
/Pyros/PyroPWM1: U20.4 (INB); also elsewhere on the board
/Pyros/PyroSense0: R11.2, R12.1; also elsewhere on the board
/Pyros/PyroSense1: R9.2, R10.1; also elsewhere on the board
GND: C33.1, C34.1, C35.2, C37.2, Q1.1 (S), Q1.3 (S), R10.2, R12.2, U20.3 (GND); also elsewhere on the board
unnamed: C33.2, Q1.4 (G), U20.7 (OUTA)
unnamed: C34.2, Q1.2 (G), U20.5 (OUTB)

Parts of its further copies:
C39, C40, C45, C46: 1nF; C_0402_1005Metric
C41, C47: 10uF; C_0402_1005Metric
C43, C49: .1uF; C_0402_1005Metric
Q2, Q3: STL66DN3LLH5; POWERFLAT5X6_STL66_STM
R13, R14, R15, R16, R17, R19, R20, R21: R; R_0402_1005Metric
U21, U22: SOIC-8_3.9x4.9mm_P1.27mm

Connections of its further copies:
/Pyros/Pyro0/Armed Pyro: C41.1, C43.1, C47.1, C49.1, U21.6 (VCC), U22.6 (VCC); also elsewhere on the board
/Pyros/Pyro1/Pyro0 Neg: Q2.5 (D), Q2.6 (D), R15.1
/Pyros/Pyro1/Pyro1 Neg: Q2.7 (D), Q2.8 (D), R13.1
/Pyros/Pyro2/Pyro0 Neg: Q3.5 (D), Q3.6 (D), R20.1
/Pyros/Pyro2/Pyro1 Neg: Q3.7 (D), Q3.8 (D), R17.1
/Pyros/PyroPWM2: U21.2 (INA); also elsewhere on the board
/Pyros/PyroPWM3: U21.4 (INB); also elsewhere on the board
/Pyros/PyroPWM4: U22.2 (INA); also elsewhere on the board
/Pyros/PyroPWM5: U22.4 (INB); also elsewhere on the board
/Pyros/PyroSense2: R15.2, R16.1; also elsewhere on the board
/Pyros/PyroSense3: R13.2, R14.1; also elsewhere on the board
/Pyros/PyroSense4: R20.2, R21.1; also elsewhere on the board
/Pyros/PyroSense5: R17.2, R19.1; also elsewhere on the board
GND: C39.1, C40.1, C41.2, C43.2, C45.1, C46.1, C47.2, C49.2, Q2.1 (S), Q2.3 (S), Q3.1 (S), Q3.3 (S), R14.2, R16.2, R19.2, R21.2, U21.3 (GND), U22.3 (GND); also elsewhere on the board
unnamed: C39.2, Q2.4 (G), U21.7 (OUTA)
unnamed: C40.2, Q2.2 (G), U21.5 (OUTB)
unnamed: C45.2, Q3.4 (G), U22.7 (OUTA)
unnamed: C46.2, Q3.2 (G), U22.5 (OUTB)

Notes on the sheet:
3.3V = (26V * R2)/(R1 + R2) 0.127 = R2 / (R1 + R2) -> 0.1 = R2 / (R1 + R2) R2 = 10k R1 = 90k (R2 + R1) = 100k V = IR 26V / 100k = 0.26mA Disarmed w/continuity = (3.3-0.7) * 0.1 = 0.26V Armed w/continuity = 26 * 0.1 = 2.6V

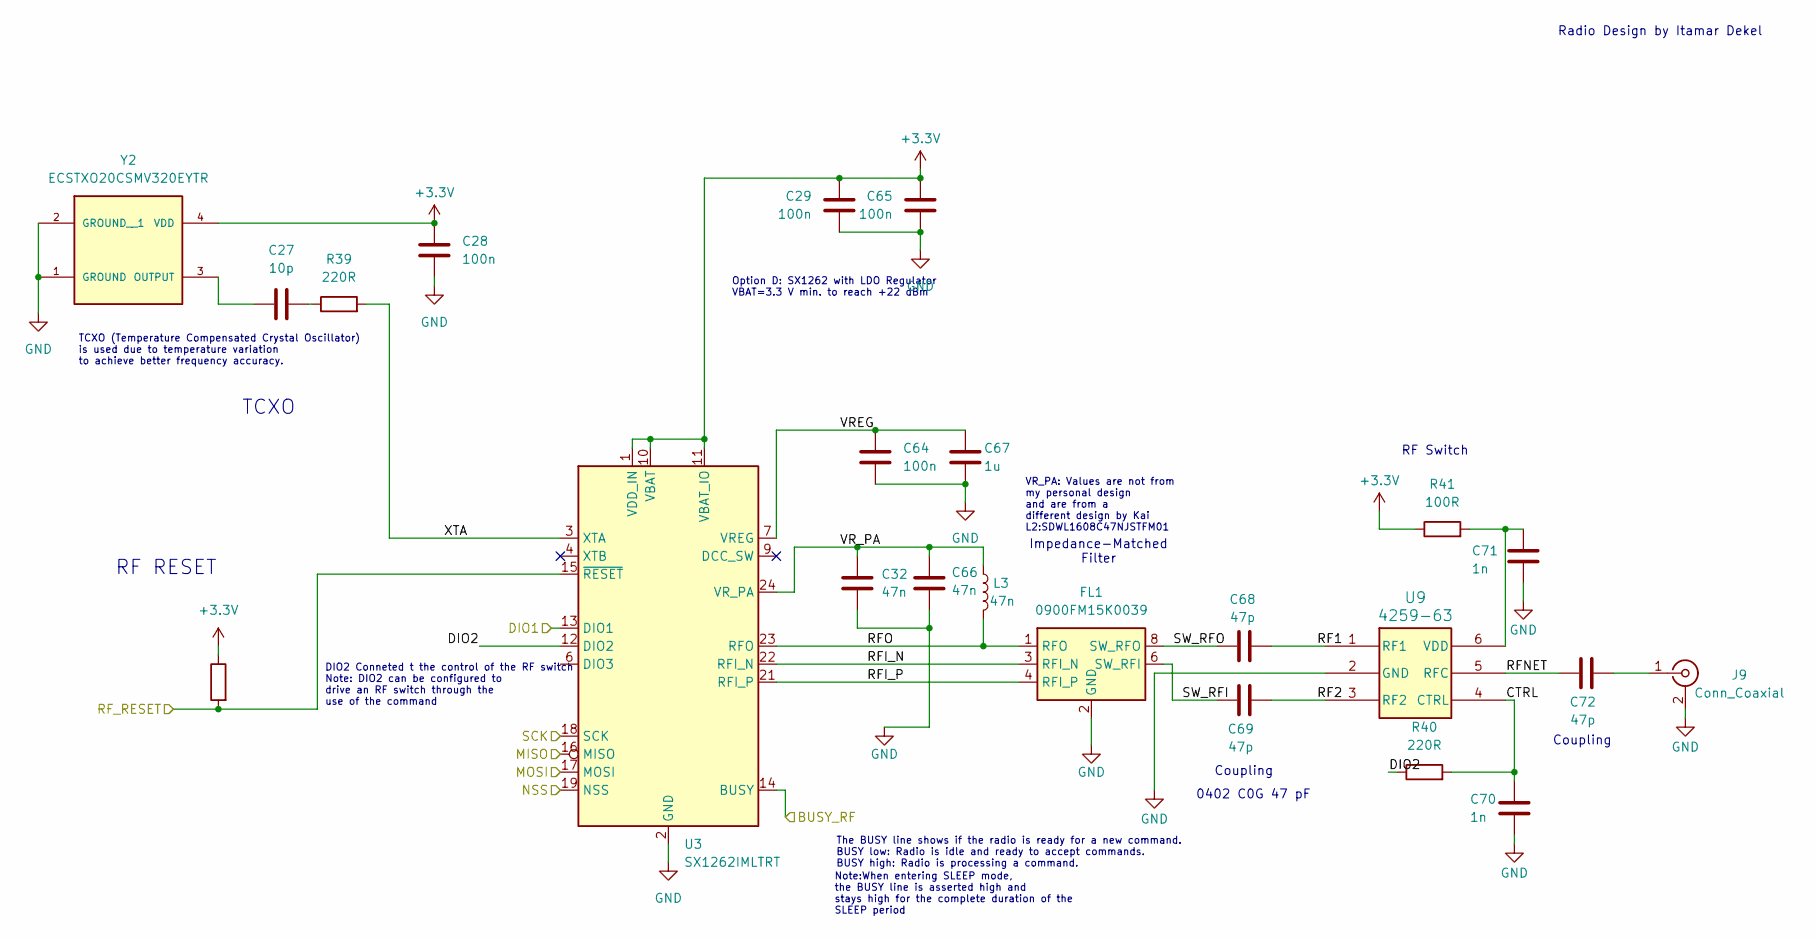
[picture p11: schematic radio.kicad_sch]

Parts:
C27: 10p; C_0402_1005Metric
C28, C29, C64, C65: 100n; C_0402_1005Metric
C32, C66: 47n; C_0402_1005Metric
C67: 1u; C_0402_1005Metric
C68, C69, C72: 47p; C_0402_1005Metric
C70, C71: 1n; C_0402_1005Metric
FL1: 0900FM15K0039; Balun_Johanson_0900FM15K0039
J9: Conn_Coaxial; SMA_Molex_73251-1153_EdgeMount_Horizontal
L3: 47n; L_0603_1608Metric
R36: 10k; R_0402_1005Metric
R39, R40: 220R; R_0402_1005Metric
R41: 100R; R_0402_1005Metric
U3: SX1262IMLTRT; QFN-24-1EP_4x4mm_P0.5mm_EP2.6x2.6mm
U9: 4259-63; SC-70-6_PSM-L
Y2: ECSTXO20CSMV320EYTR; OSC_ECSTXO20CSMV320EYTR; PARTREV N/A

Connections:
+3.3V: C28.1, C29.1, C65.1, R36.1, R41.1, U3.1 (VDD_IN), U3.10 (VBAT), U3.11 (VBAT_IO), Y2.4 (VDD); also elsewhere on the board
/GPSRadio/Busy Radio: U3.14 (BUSY); also elsewhere on the board
/GPSRadio/CS Radio: U3.19 (NSS); also elsewhere on the board
/GPSRadio/Dio1 Radio: U3.13 (DIO1); also elsewhere on the board
/GPSRadio/Miso2: U3.16 (MISO); also elsewhere on the board
/GPSRadio/Mosi2: U3.17 (MOSI); also elsewhere on the board
/GPSRadio/Radio/CTRL: C70.2, R40.2, U9.4 (CTRL)
/GPSRadio/Radio/DIO2: R40.1, U3.12 (DIO2)
/GPSRadio/Radio/RF1: C68.1, U9.1 (RF1)
/GPSRadio/Radio/RF2: C69.1, U9.3 (RF2)
/GPSRadio/Radio/RFI_N: FL1.3 (RFI_N), U3.22 (RFI_N)
/GPSRadio/Radio/RFI_P: FL1.4 (RFI_P), U3.21 (RFI_P)
/GPSRadio/Radio/RFNET: C72.2, U9.5 (RFC)
/GPSRadio/Radio/RFO: FL1.1 (RFO), L3.2, U3.23 (RFO)
/GPSRadio/Radio/SW_RFI: C69.2, FL1.6 (SW_RFI)
/GPSRadio/Radio/SW_RFO: C68.2, FL1.8 (SW_RFO)
/GPSRadio/Radio/VREG: C64.1, C67.1, U3.7 (VREG)
/GPSRadio/Radio/VR_PA: C32.2, C66.2, L3.1, U3.24 (VR_PA)
/GPSRadio/Radio/XTA: R39.2, U3.3 (XTA)
/GPSRadio/Reset Radio: R36.2, U3.15 (~RESET); also elsewhere on the board
/GPSRadio/Sck2: U3.18 (SCK); also elsewhere on the board
GND: C28.2, C29.2, C32.1, C64.2, C65.2, C66.1, C67.2, C70.1, C71.1, FL1.2 (GND), FL1.5 (GND), FL1.7 (GND), FL1.9 (GND), FL1.10 (GND), J9.2 (Ext), U3.2 (GND), U3.5 (GND), U3.8 (GND), U3.20 (GND), U3.25 (GND), U9.2 (GND), Y2.1 (GROUND), Y2.2 (GROUND__1); also elsewhere on the board
unnamed: C27.1, R39.1
unnamed: C72.1, J9.1 (In)
unnamed: C71.2, R41.2, U9.6 (VDD)
unnamed: C27.2, Y2.3 (OUTPUT)

Notes on the sheet:
Coupling
0402 C0G 47 pF
Option D: SX1262 with LDO Regulator VBAT=3.3 V min. to reach +22 dBm
DIO2 Conneted t the control of the RF switch Note: DIO2 can be configured to drive an RF switch through the use of the command
Note:When entering SLEEP mode, the BUSY line is asserted high and stays high for the complete duration of the SLEEP period
The BUSY line shows if the radio is ready for a new command. BUSY low: Radio is idle and ready to accept commands. BUSY high: Radio is processing a command.
VR_PA: Values are not from my personal design and are from a different design by Kai L2:SDWL1608C47NJSTFM01
TCXO
TCXO (Temperature Compensated Crystal Oscillator) is used due to temperature variation to achieve better frequency accuracy.
Impedance-Matched Filter
RF RESET
RF Switch
Radio Design by Itamar Dekel

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
Board: 4 copper layers, 156 parts (0 on the bottom side), 141 nets, no tracks yet.
