Magicraps/Volt/(commit log)

2025-12-16 syncing. Power not done yet
    [GPSRadio.kicad_sch, IO.kicad_sch, Pyro.kicad_sch, Pyros.kicad_sch, VoltV1.kicad_pcb, VoltV1.kicad_sch, daughterInterface.kicad_sch, flash.kicad_sch]
2026-03-07 merging. power stuff incomplete
    [GPSRadio.kicad_sch, IO.kicad_sch, Pyro.kicad_sch, Pyros.kicad_sch, VoltV1.kicad_sch, daughterInterface.kicad_sch, mcu.kicad_sch, power.kicad_sch]
2026-06-28 updates to schematic
    [GPSRadio.kicad_sch, IO.kicad_sch, VoltV1.kicad_pcb, VoltV1.kicad_sch, power.kicad_sch, radio.kicad_sch, sensors.kicad_sch, storage.kicad_sch]
2026-06-28 schematic updates
    [GPSRadio.kicad_sch, IO.kicad_sch, Pyro.kicad_sch, Pyros.kicad_sch, VoltV1.kicad_pcb, mcu.kicad_sch, power.kicad_sch, radio.kicad_sch]
